yeremybautista77/Maquina_Expendedora/Firmware/imagenes_productos/p2.jpg

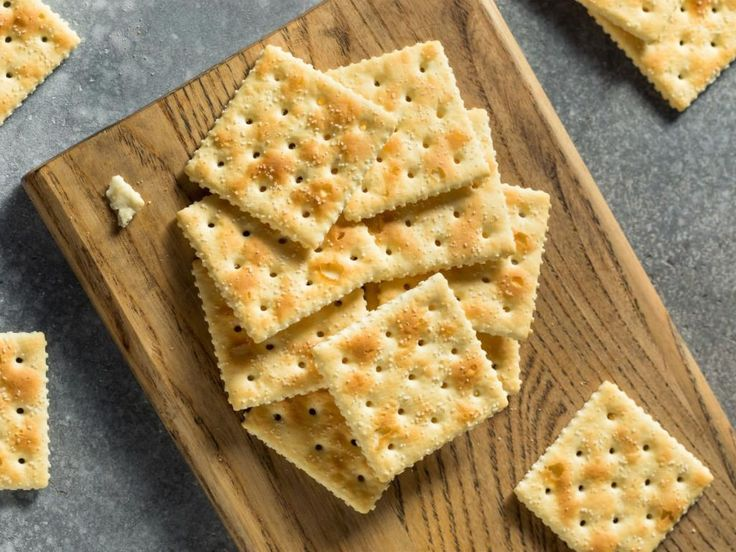
Firmware/imagenes_productos/p2.jpg
