yeremybautista77/Maquina_Expendedora/Firmware/imagenes_productos/p1.jpg

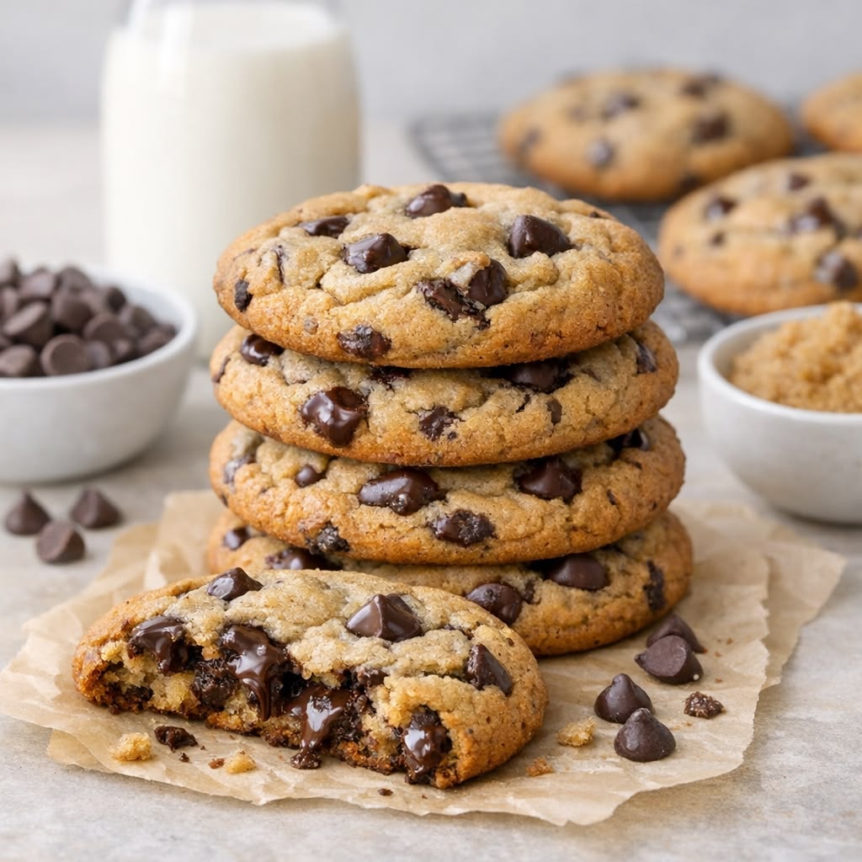
Firmware/imagenes_productos/p1.jpg
