yeremybautista77/Maquina_Expendedora/Diseño_electronico/img/README.md

Carpeta para fotografías y diagramas del documento ARQUITECTURA_HARDWARE.md.

Nombres esperados (ver índice de figuras, sección 5.1):

- placa_hosyond_esp32_32e.png
- cableado_general.png
- fuente_12v.png
- stepdown_lm2596.png
- optoacoplador_pc817.png
- monedero_ch926.png
- modulo_reles.png
- bus_i2c.png
- pantalla_st7796.png
- borneras_conexion.png
