yeremybautista77/Maquina_Expendedora/Diseño_mecanico/motor dc/motor main.SLDPRT

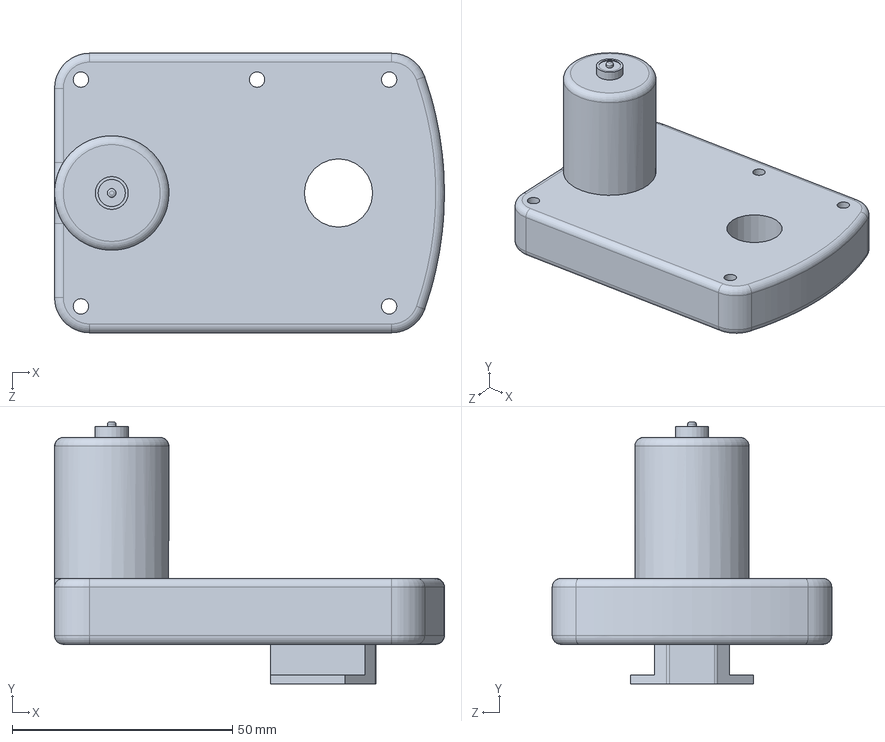
[picture p3: CAD file, 2026-11-04]
Diseño_mecanico/motor dc/motor main.SLDPRT
88.6 x 59.5 x 63.5 mm
