yeremybautista77/Maquina_Expendedora/Diseño_mecanico/motor dc/Ensamblaje de motor.SLDASM

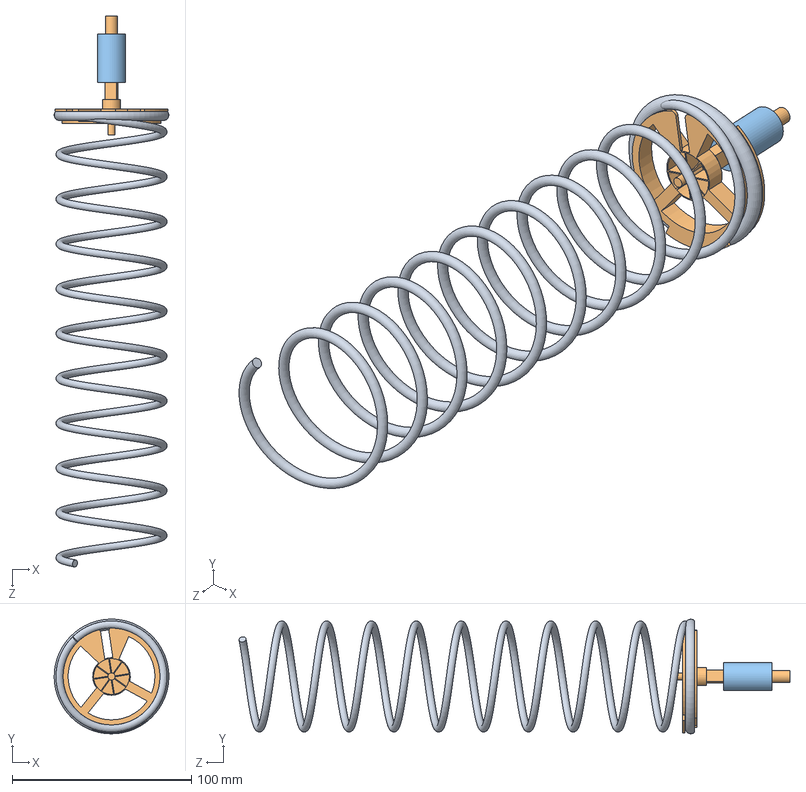
[picture p4: CAD file, 2026-11-04]
Diseño_mecanico/motor dc/Ensamblaje de motor.SLDASM
64.0 x 64.0 x 307.3 mm
eje de base del motor
base de resorte
espiral
