yeremybautista77/Maquina_Expendedora/Diseño_mecanico/Chasis/Ensamblaje1.SLDASM

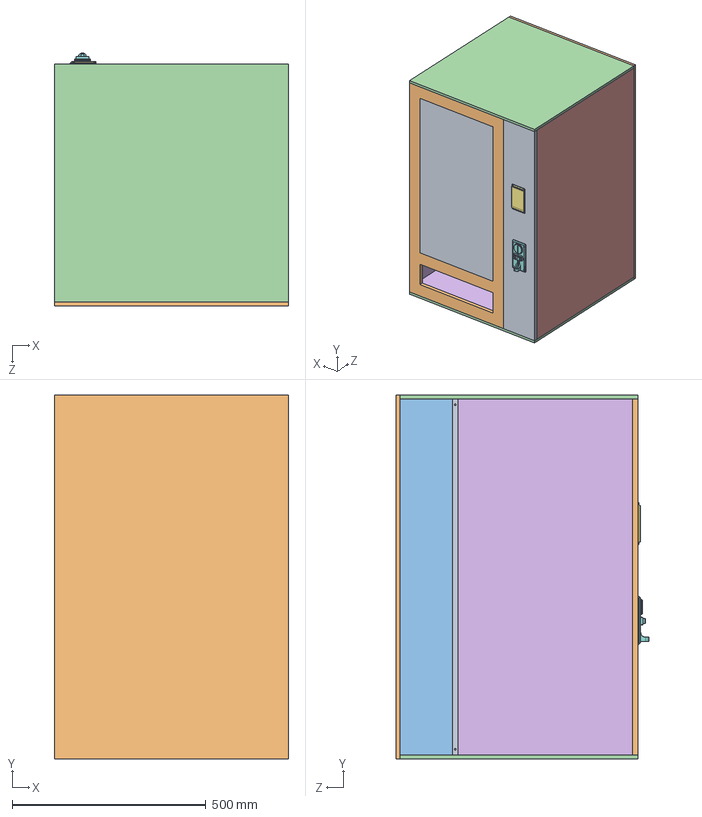
[picture p5: CAD file, 2026-11-04]
Diseño_mecanico/Chasis/Ensamblaje1.SLDASM
604.7 x 940.0 x 652.5 mm
Base de los motores
motor 2
motor main x 5
DIVISOR INTERIOR
eje de base del motor x 7
espiral x 7
base de resorte x 7
pared principal
PANEL DE CONTROL
coin acceptor
pantalla
fondo
pared exterior1
pared superior e inferior x 2
pared exterior 2
pared final
Cristal
