yeremybautista77/Maquina_Expendedora/Diseño_mecanico/Chasis/coin acceptor.SLDPRT

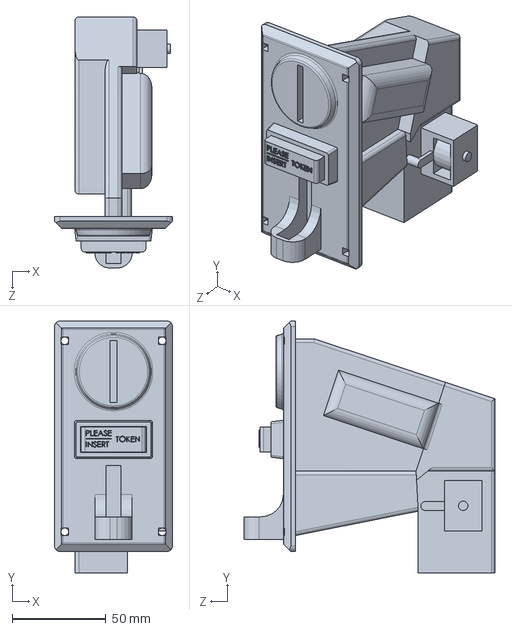
[picture p6: CAD file, 2026-11-04]
Diseño_mecanico/Chasis/coin acceptor.SLDPRT
63.0 x 134.5 x 134.0 mm
