yeremybautista77/Maquina_Expendedora/Diseño_mecanico/motor dc/espiral.SLDPRT

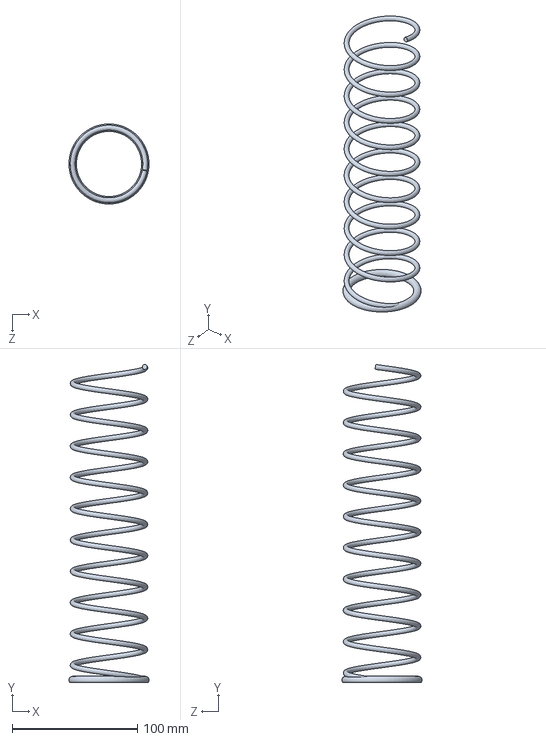
[picture p7: CAD file, 2026-11-04]
Diseño_mecanico/motor dc/espiral.SLDPRT
64.0 x 254.0 x 63.9 mm
