yeremybautista77/Maquina_Expendedora/Diseño_mecanico/Chasis/4 Inch TFT SPI 480x320 V1.2.SLDPRT

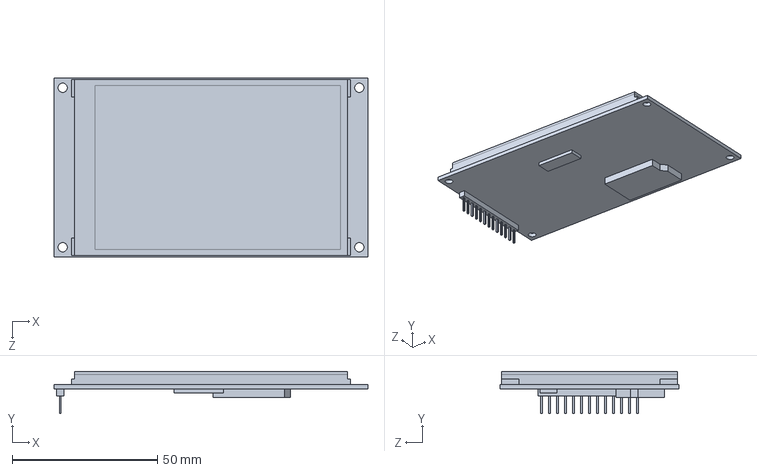
[picture p8: CAD file, 2026-11-04]
Diseño_mecanico/Chasis/4 Inch TFT SPI 480x320 V1.2.SLDPRT
108.0 x 14.5 x 61.7 mm
