yeremybautista77/Maquina_Expendedora/Diseño_mecanico/motor dc/motor 2.SLDPRT

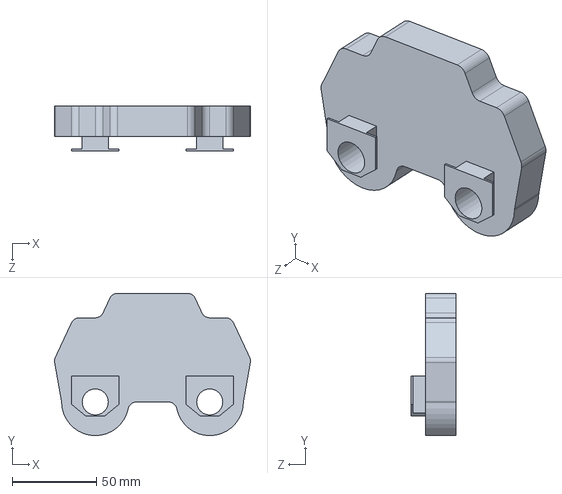
[picture p9: CAD file, 2026-11-04]
Diseño_mecanico/motor dc/motor 2.SLDPRT
116.4 x 84.5 x 26.5 mm
