yeremybautista77/Maquina_Expendedora/Diseño_mecanico/Chasis/fondo.SLDPRT

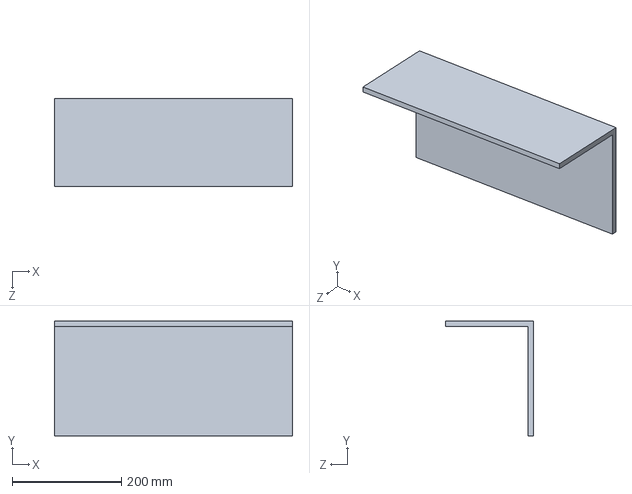
[picture p10: CAD file, 2026-11-04]
Diseño_mecanico/Chasis/fondo.SLDPRT
434.7 x 210.0 x 160.0 mm
