yeremybautista77/Maquina_Expendedora/Diseño_mecanico/Chasis/pared exterior1.SLDPRT

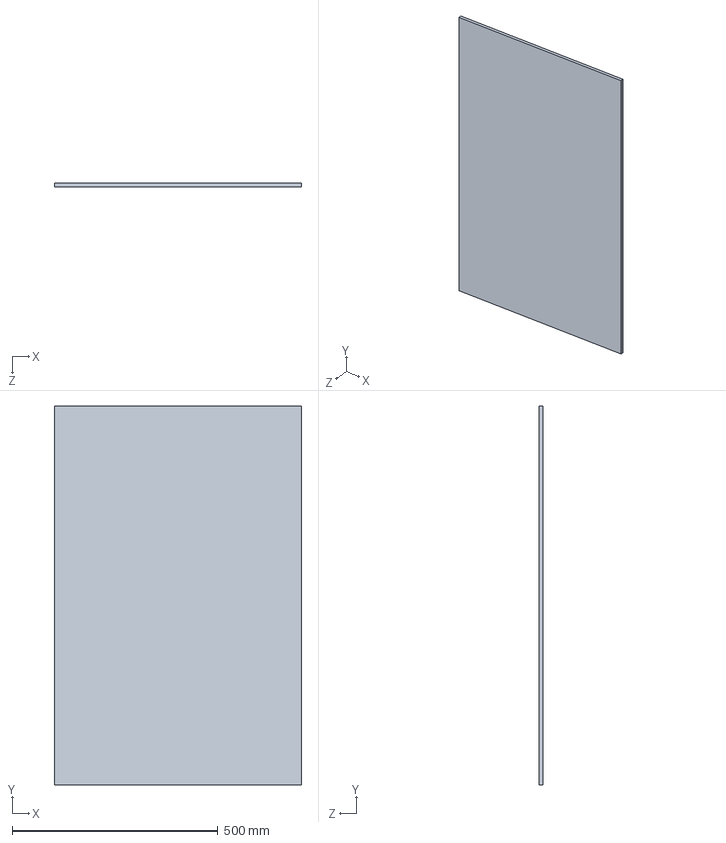
[picture p11: CAD file, 2026-11-04]
Diseño_mecanico/Chasis/pared exterior1.SLDPRT
600.0 x 920.0 x 10.0 mm
