yeremybautista77/Maquina_Expendedora/Diseño_mecanico/motor dc/eje de base del motor.SLDPRT

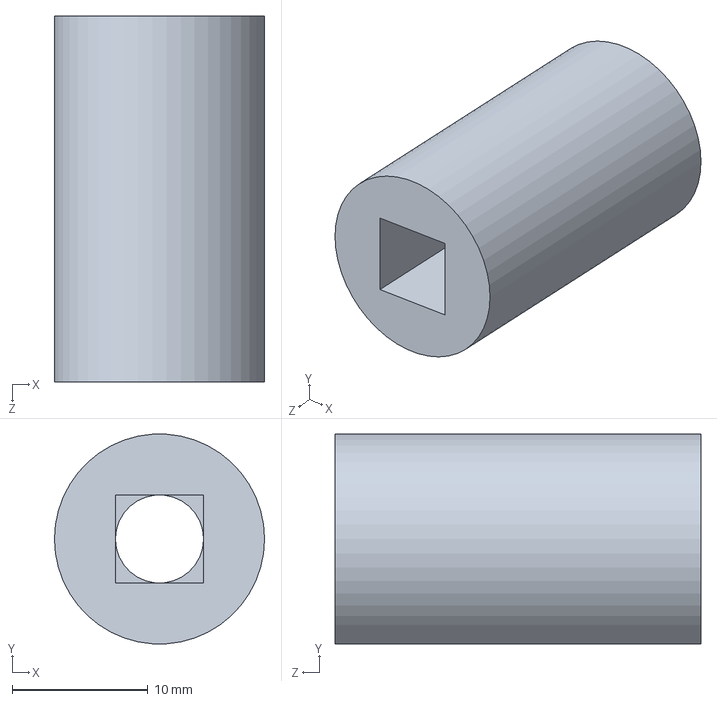
[picture p12: CAD file, 2026-11-04]
Diseño_mecanico/motor dc/eje de base del motor.SLDPRT
15.5 x 15.5 x 27.0 mm
