yeremybautista77/Maquina_Expendedora/Diseño_mecanico/Chasis/PANEL DE CONTROL.SLDPRT

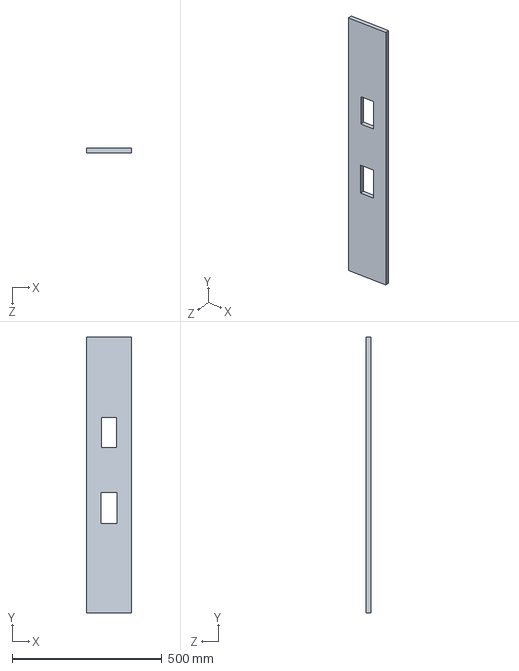
[picture p14: CAD file, 2026-11-04]
Diseño_mecanico/Chasis/PANEL DE CONTROL.SLDPRT
150.0 x 920.0 x 15.0 mm
