yeremybautista77/Maquina_Expendedora/Diseño_mecanico/motor dc/base de resorte.SLDPRT

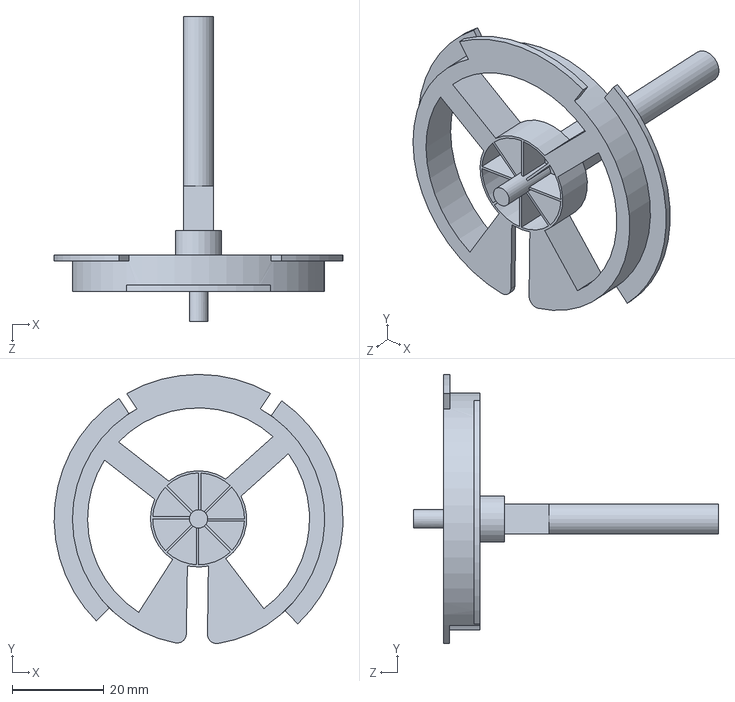
[picture p15: CAD file, 2026-11-04]
Diseño_mecanico/motor dc/base de resorte.SLDPRT
62.9 x 58.7 x 66.5 mm
