yeremybautista77/Maquina_Expendedora/Diseño_mecanico/Chasis/Cristal.SLDPRT

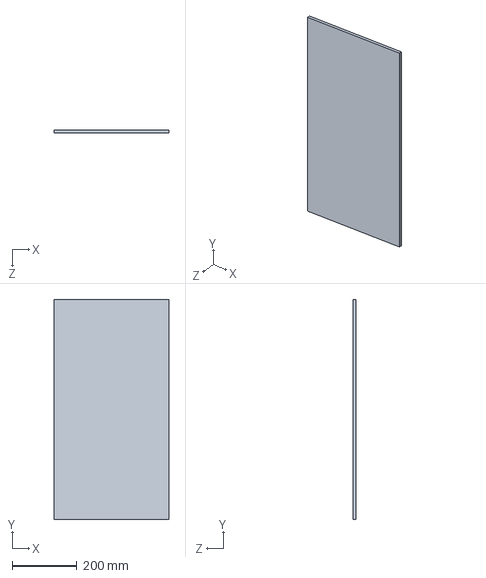
[picture p16: CAD file, 2026-11-04]
Diseño_mecanico/Chasis/Cristal.SLDPRT
354.7 x 680.0 x 10.0 mm
