yeremybautista77/Maquina_Expendedora/Diseño_mecanico/Chasis/pared exterior 2.SLDPRT

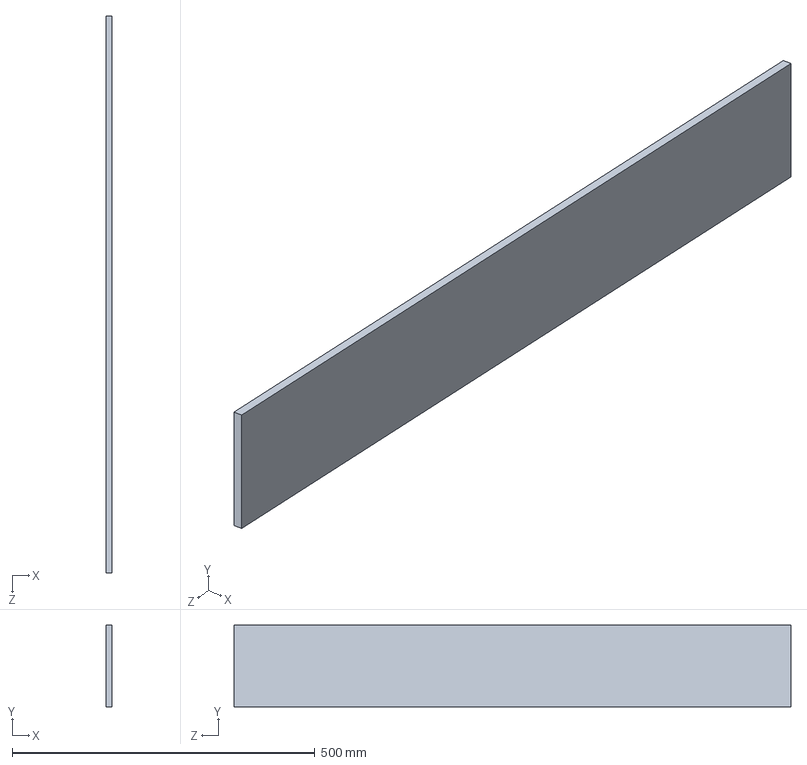
[picture p17: CAD file, 2026-11-04]
Diseño_mecanico/Chasis/pared exterior 2.SLDPRT
10.0 x 135.0 x 920.0 mm
