yeremybautista77/Maquina_Expendedora/Diseño_mecanico/Chasis/Base de los motores.SLDPRT

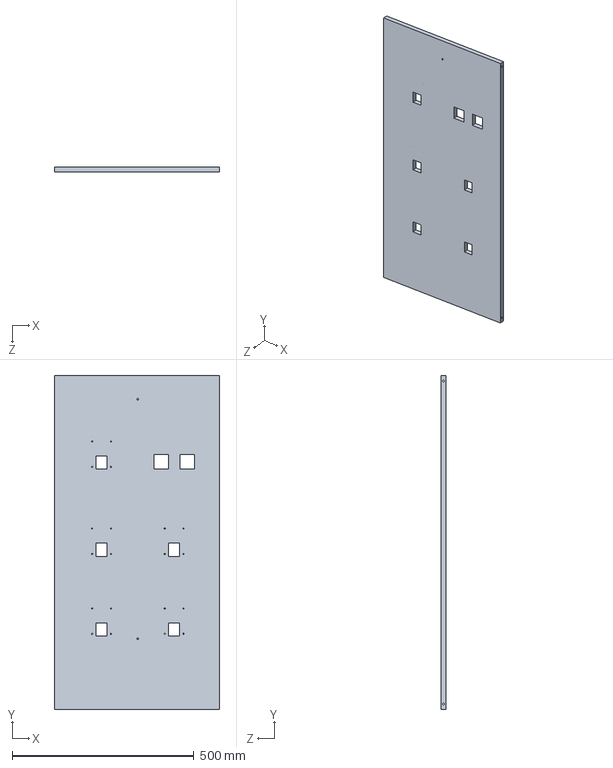
[picture p18: CAD file, 2026-11-04]
Diseño_mecanico/Chasis/Base de los motores.SLDPRT
454.7 x 920.0 x 15.0 mm
