yeremybautista77/Maquina_Expendedora/Diseño_mecanico/Chasis/pared final.SLDPRT

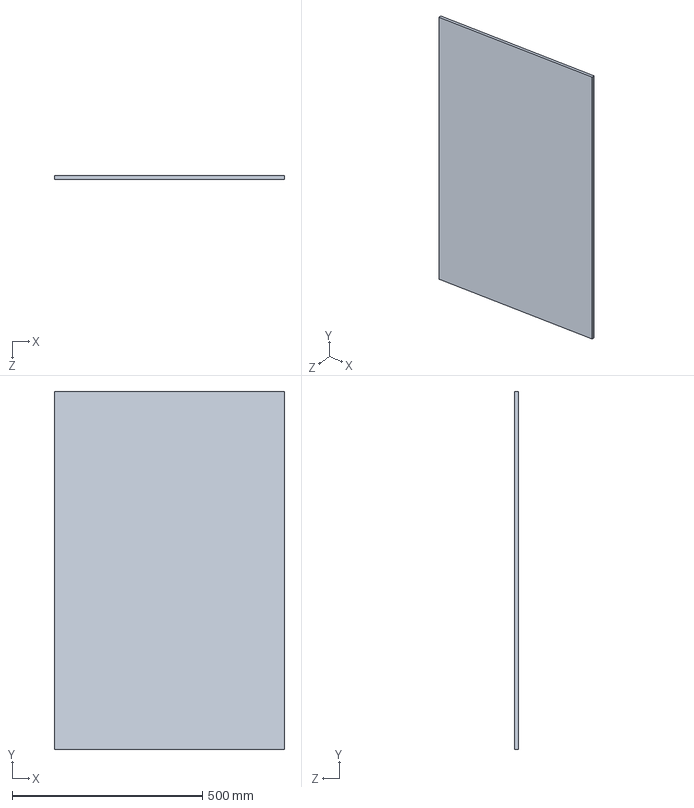
[picture p19: CAD file, 2026-11-04]
Diseño_mecanico/Chasis/pared final.SLDPRT
604.7 x 940.0 x 10.0 mm
