yeremybautista77/Maquina_Expendedora/Diseño_mecanico/Chasis/ultimas paredes.SLDPRT

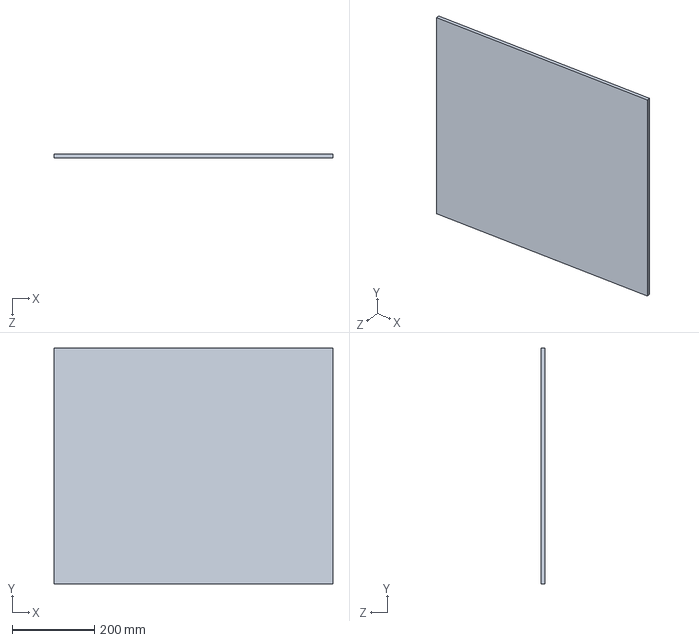
[picture p20: CAD file, 2026-11-04]
Diseño_mecanico/Chasis/ultimas paredes.SLDPRT
680.0 x 575.0 x 10.0 mm
