yeremybautista77/Maquina_Expendedora/Diseño_mecanico/Chasis/pared superior e inferior.SLDPRT

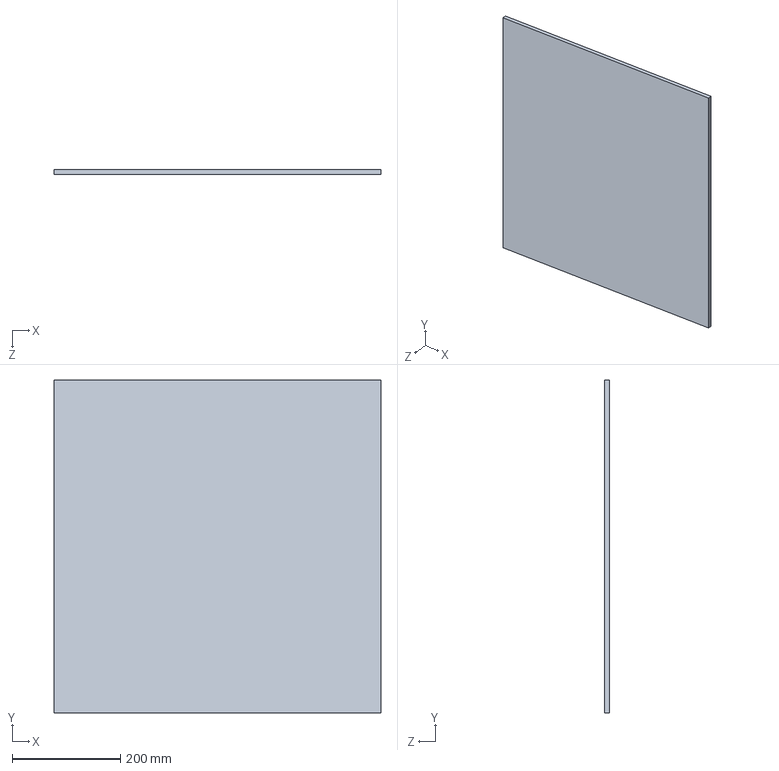
[picture p21: CAD file, 2026-11-04]
Diseño_mecanico/Chasis/pared superior e inferior.SLDPRT
604.7 x 615.0 x 10.0 mm
