yeremybautista77/Maquina_Expendedora/Diseño_mecanico/Chasis/DIVISOR INTERIOR.SLDPRT

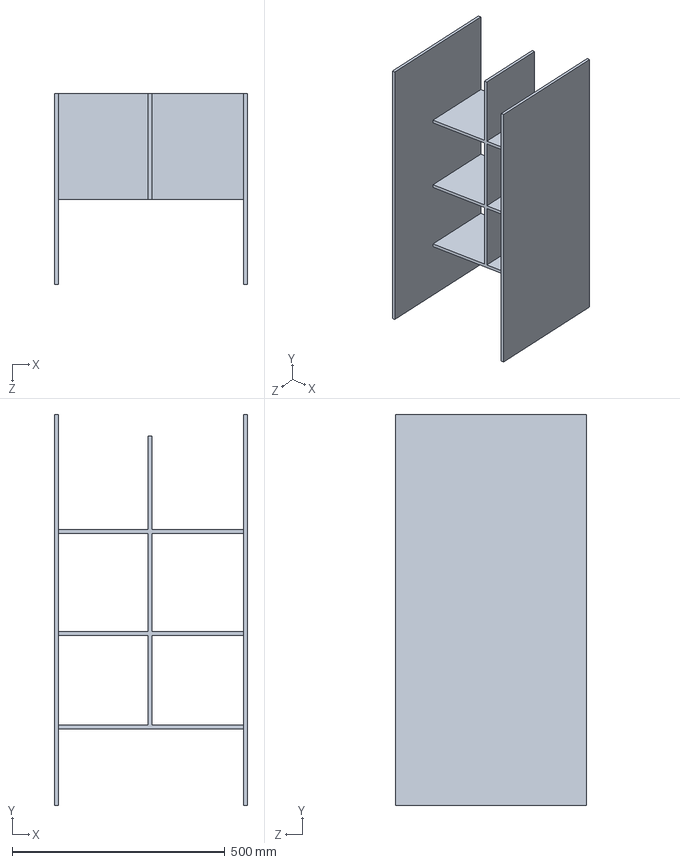
[picture p22: CAD file, 2026-11-04]
Diseño_mecanico/Chasis/DIVISOR INTERIOR.SLDPRT
454.7 x 920.0 x 450.0 mm
