yeremybautista77/Maquina_Expendedora/Diseño_mecanico/Chasis/PARED INTERIOR.SLDPRT

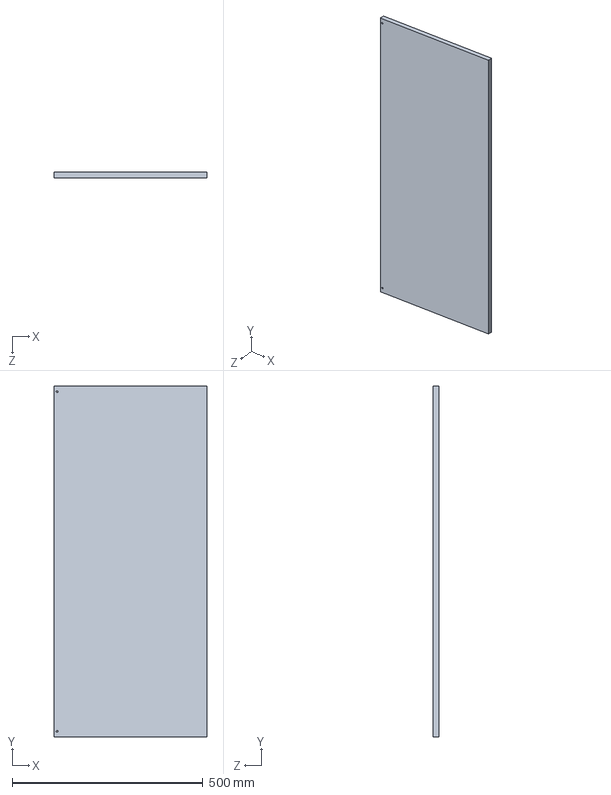
[picture p23: CAD file, 2026-11-04]
Diseño_mecanico/Chasis/PARED INTERIOR.SLDPRT
400.0 x 920.0 x 15.0 mm
