yeremybautista77/Maquina_Expendedora/(list of files, cad)

Other CAD files:
Diseño_mecanico/coin acceptor.SLDPRT
Diseño_mecanico/Chasis/pantalla.SLDPRT
