yeremybautista77/Maquina_Expendedora/Firmware/main/motor_control.c

/**
 * @file motor_control.c
 * @brief Control I2C de los 6 motores mediante el PCF8574 0x20 y lectura de
 *        los sensores de posicion M1..M4 por el PCF8574 0x21.
 *
 * Estrategia:
 *   - M1..M4 (con sensor): se energiza el rele y se espera el pulso de home
 *     para detener el motor en la misma posicion en cada vuelta. El pulso por
 *     tiempo actua como techo de seguridad si el sensor no responde.
 *   - M5..M6 (sin sensor): lazo abierto con MOTOR_TIMED_PULSE_MS.
 *   - Si el expansor 0x21 no responde, los 6 canales usan lazo abierto.
 *
 * SPDX-License-Identifier: MIT
 */

#include "motor_control.h"

#include <inttypes.h>
#include <stddef.h>

#include "board_config.h"
#include "esp_log.h"
#include "freertos/task.h"
#include "sensor_input.h"

static const char *TAG = "motor_control";

_Static_assert(MOTOR_CHANNEL_COUNT == BOARD_CHANNEL_COUNT,
               "El numero de canales de motor debe coincidir con el hardware");
_Static_assert(BOARD_SENSOR_CHANNEL_COUNT <= MOTOR_CHANNEL_COUNT,
               "Los canales con sensor deben ser un subconjunto de los motores");

/** Handle I2C del PCF8574 de relees (0x20). */
static i2c_master_dev_handle_t s_relay_dev = NULL;

/* La lectura del PCF8574 0x21 vive en sensor_input.c. */

/** Registro sombra: bit n = 1 significa que el canal n esta activo. */
static uint8_t s_relay_shadow = 0;

/** Mutex que serializa el acceso al bus I2C. */
static SemaphoreHandle_t s_i2c_mutex = NULL;

/** Cola de solicitudes de despacho. */
static QueueHandle_t s_dispatch_queue = NULL;

/** Mutex que protege la cola (productor GUI / consumidor motor_task). */
static SemaphoreHandle_t s_queue_mutex = NULL;

/** true mientras motor_control_dispatch_one() tiene el Mutex de despacho. */
static volatile bool s_dispatching = false;

/** true mientras motor_task esta procesando una solicitud o vaciando la cola. */
static volatile bool s_task_active = false;

/** Callback de eventos de despacho (registrado por main.c). */
static motor_event_cb_t s_event_cb = NULL;
static void *s_event_ctx = NULL;

/* --- Utilidades internas -------------------------------------------------- */

/**
 * @brief Emite un evento al callback registrado (contexto de motor_task).
 */
static void emit_event(motor_event_type_t type, uint8_t channel, uint8_t units,
                       esp_err_t error, bool admin_test)
{
    const motor_event_cb_t callback = s_event_cb;
    if (callback == NULL) {
        return;
    }

    const motor_event_t event = {
        .type = type,
        .channel = channel,
        .units = units,
        .error = error,
        .admin_test = admin_test,
    };
    callback(&event, s_event_ctx);
}

/**
 * @brief Agrega el PCF8574 al bus I2C.
 */
static esp_err_t add_expander(i2c_master_bus_handle_t bus, uint8_t address,
                              i2c_master_dev_handle_t *out_dev)
{
    const i2c_device_config_t dev_cfg = {
        .dev_addr_length = I2C_ADDR_BIT_LEN_7,
        .device_address = address,
        .scl_speed_hz = BOARD_I2C_CLOCK_HZ,
    };

    return i2c_master_bus_add_device(bus, &dev_cfg, out_dev);
}

/**
 * @brief Escribe un byte en un PCF8574 bajo el Mutex del bus.
 */
static esp_err_t write_expander(i2c_master_dev_handle_t dev, uint8_t value)
{
    if (dev == NULL || s_i2c_mutex == NULL) {
        return ESP_ERR_INVALID_STATE;
    }
    if (xSemaphoreTake(s_i2c_mutex, pdMS_TO_TICKS(100)) != pdTRUE) {
        return ESP_ERR_TIMEOUT;
    }

    esp_err_t err = i2c_master_transmit(dev, &value, sizeof(value), 100);

    xSemaphoreGive(s_i2c_mutex);
    return err;
}

/* --- API publica ---------------------------------------------------------- */

esp_err_t motor_control_init(i2c_master_bus_handle_t i2c_bus)
{
    if (i2c_bus == NULL) {
        return ESP_ERR_INVALID_ARG;
    }
    if (s_relay_dev != NULL && s_dispatch_queue != NULL &&
        s_queue_mutex != NULL) {
        return ESP_OK; /* Ya inicializado. */
    }

    s_i2c_mutex = xSemaphoreCreateMutex();
    if (s_i2c_mutex == NULL) {
        return ESP_ERR_NO_MEM;
    }

    /*
     * Diagnostico de presencia: add_device no verifica que el PCF8574 exista.
     * El probe deja en el log si 0x20 responde antes de escribir.
     */
    if (i2c_master_probe(i2c_bus, BOARD_I2C_ADDR_RELAY, 50) == ESP_OK) {
        ESP_LOGI(TAG, "PCF8574 de relees detectado en 0x%02X",
                 BOARD_I2C_ADDR_RELAY);
    } else {
        ESP_LOGE(TAG,
                 "PCF8574 de relees NO responde en 0x%02X (revise SDA/SCL, "
                 "3.3 V y GND comun)",
                 BOARD_I2C_ADDR_RELAY);
    }

    esp_err_t err = add_expander(i2c_bus, BOARD_I2C_ADDR_RELAY, &s_relay_dev);
    if (err != ESP_OK) {
        ESP_LOGE(TAG, "No se pudo registrar el PCF8574 de relees (0x%02X): %s",
                 BOARD_I2C_ADDR_RELAY, esp_err_to_name(err));
        goto fail;
    }

    /*
     * Estado seguro al arrancar: todos los canales apagados.
     * Con el inversor NPN (BOARD_RELAY_ACTIVE_LOW = 0) apagar es escribir LOW
     * en todos los bits (0x00): los transistores quedan al corte y la entrada
     * IN de cada modulo queda en alto (rele desenergizado).
     */
    s_relay_shadow = 0x00;
#if BOARD_RELAY_ACTIVE_LOW
    const uint8_t relay_off = 0xFF;
#else
    const uint8_t relay_off = 0x00;
#endif
    err = write_expander(s_relay_dev, relay_off);
    if (err != ESP_OK) {
        ESP_LOGE(TAG, "No se pudo apagar los relees al inicio: %s",
                 esp_err_to_name(err));
        goto fail;
    }

    s_queue_mutex = xSemaphoreCreateMutex();
    if (s_queue_mutex == NULL) {
        ESP_LOGE(TAG, "Sin memoria para el Mutex de la cola de despacho");
        err = ESP_ERR_NO_MEM;
        goto fail;
    }

    s_dispatch_queue = xQueueCreate(MOTOR_QUEUE_LENGTH, sizeof(motor_request_t));
    if (s_dispatch_queue == NULL) {
        ESP_LOGE(TAG, "Sin memoria para la cola de despacho");
        err = ESP_ERR_NO_MEM;
        goto fail;
    }

    /*
     * PCF8574 de sensores (0x21). Es opcional: si no responde, la maquina
     * sigue funcionando en lazo abierto por tiempo. La gestion del expansor y
     * la interpretacion del home viven en sensor_input.c.
     */
#if BOARD_SENSOR_ENABLED
    esp_err_t sensor_err = sensor_input_init(i2c_bus);
    if (sensor_err != ESP_OK) {
        ESP_LOGW(TAG,
                 "Sensores no disponibles (%s); M1-M%u pasaran a lazo abierto",
                 esp_err_to_name(sensor_err),
                 (unsigned)BOARD_SENSOR_CHANNEL_COUNT);
    }
#endif /* BOARD_SENSOR_ENABLED */

    if (sensor_input_available()) {
        ESP_LOGI(TAG,
                 "Control de motores listo (relees 0x%02X; sensores 0x%02X en "
                 "M1-M%u; M%u-M%u por tiempo %d ms)",
                 BOARD_I2C_ADDR_RELAY, BOARD_I2C_ADDR_SENSOR,
                 (unsigned)BOARD_SENSOR_CHANNEL_COUNT,
                 (unsigned)(BOARD_SENSOR_CHANNEL_COUNT + 1),
                 (unsigned)MOTOR_CHANNEL_COUNT, MOTOR_TIMED_PULSE_MS);
    } else {
        ESP_LOGI(TAG,
                 "Control de motores listo (relees 0x%02X; M1-M%u por tiempo, "
                 "%d ms)",
                 BOARD_I2C_ADDR_RELAY, (unsigned)MOTOR_CHANNEL_COUNT,
                 MOTOR_TIMED_PULSE_MS);
    }

#if BOARD_SENSOR_ENABLED && BOARD_SENSOR_HOMING_ENABLED
    /*
     * Homing opcional de arranque. Se ejecuta antes de crear motor_task, por
     * lo que no compite con ningun despacho. Un fallo no impide arrancar.
     */
    if (sensor_input_available()) {
        (void)motor_control_home_all();
    }
#endif

    return ESP_OK;

fail:
    if (s_dispatch_queue != NULL) {
        vQueueDelete(s_dispatch_queue);
        s_dispatch_queue = NULL;
    }
    if (s_queue_mutex != NULL) {
        vSemaphoreDelete(s_queue_mutex);
        s_queue_mutex = NULL;
    }
    if (s_relay_dev != NULL) {
        i2c_master_bus_rm_device(s_relay_dev);
        s_relay_dev = NULL;
    }
    if (s_i2c_mutex != NULL) {
        vSemaphoreDelete(s_i2c_mutex);
        s_i2c_mutex = NULL;
    }
    return err;
}

esp_err_t motor_control_set_relay(uint8_t channel, bool enabled)
{
    if (channel >= MOTOR_CHANNEL_COUNT) {
        return ESP_ERR_INVALID_ARG;
    }
    if (s_relay_dev == NULL || s_i2c_mutex == NULL) {
        return ESP_ERR_INVALID_STATE;
    }
    if (xSemaphoreTake(s_i2c_mutex, pdMS_TO_TICKS(100)) != pdTRUE) {
        return ESP_ERR_TIMEOUT;
    }

    const uint8_t mask = (uint8_t)(1u << channel);
    const uint8_t new_shadow = enabled ? (uint8_t)(s_relay_shadow | mask)
                                       : (uint8_t)(s_relay_shadow & (uint8_t)~mask);

#if BOARD_RELAY_ACTIVE_LOW
    const uint8_t physical = (uint8_t)~new_shadow;
#else
    const uint8_t physical = new_shadow;
#endif

    esp_err_t err = ESP_FAIL;
    for (int intento = 0; intento < 3; intento++) {
        err = i2c_master_transmit(s_relay_dev, &physical, sizeof(physical), 100);
        if (err == ESP_OK) {
            break;
        }
        vTaskDelay(pdMS_TO_TICKS(10));
    }

    if (err == ESP_OK) {
        s_relay_shadow = new_shadow;
        ESP_LOGI(TAG, "Canal %u -> %s (0x20 = 0x%02X)",
                 (unsigned)(channel + 1), enabled ? "ON" : "OFF",
                 (unsigned)physical);
    } else {
        ESP_LOGW(TAG, "Canal %u: fallo I2C al %s (%s)", (unsigned)(channel + 1),
                 enabled ? "encender" : "apagar", esp_err_to_name(err));
    }

    xSemaphoreGive(s_i2c_mutex);
    return err;
}

bool motor_control_sensors_available(void)
{
    return sensor_input_available();
}

bool motor_control_channel_uses_sensor(uint8_t channel)
{
    return sensor_input_is_channel(channel);
}

esp_err_t motor_control_read_sensors(uint8_t *out_mask)
{
    if (out_mask == NULL) {
        return ESP_ERR_INVALID_ARG;
    }
    if (!sensor_input_available()) {
        return ESP_ERR_NOT_SUPPORTED;
    }
    return sensor_input_read_mask(out_mask);
}

esp_err_t motor_control_read_sensor(uint8_t channel, bool *out_home)
{
    if (channel >= MOTOR_CHANNEL_COUNT || out_home == NULL) {
        return ESP_ERR_INVALID_ARG;
    }
    if (!motor_control_channel_uses_sensor(channel)) {
        /* M5/M6 no tienen micro-switch: se despachan por tiempo. */
        return ESP_ERR_NOT_SUPPORTED;
    }

    esp_err_t err = sensor_input_read_channel(channel, out_home);
    if (err == ESP_ERR_INVALID_STATE) {
        /* El expansor no esta disponible: se informa como no soportado. */
        return ESP_ERR_NOT_SUPPORTED;
    }
    return err;
}

esp_err_t motor_control_home_all(void)
{
    if (!sensor_input_available()) {
        return ESP_ERR_NOT_SUPPORTED;
    }
    if (g_dispatch_mutex == NULL) {
        return ESP_ERR_INVALID_STATE;
    }

    esp_err_t result = ESP_OK;
    ESP_LOGI(TAG, "Homing de M1-M%u (timeout %d ms por canal)",
             (unsigned)BOARD_SENSOR_CHANNEL_COUNT,
             BOARD_SENSOR_HOMING_TIMEOUT_MS);

    for (uint8_t channel = 0; channel < BOARD_SENSOR_CHANNEL_COUNT; channel++) {
        bool at_home = false;
        esp_err_t err = motor_control_read_sensor(channel, &at_home);
        if (err != ESP_OK) {
            ESP_LOGE(TAG, "Homing canal %u: fallo leyendo el sensor: %s",
                     (unsigned)(channel + 1), esp_err_to_name(err));
            if (result == ESP_OK) {
                result = err;
            }
            continue;
        }
        if (at_home) {
            ESP_LOGI(TAG, "Homing canal %u: ya esta en reposo",
                     (unsigned)(channel + 1));
            continue;
        }

        if (xSemaphoreTake(g_dispatch_mutex,
                           pdMS_TO_TICKS(BOARD_SENSOR_HOMING_TIMEOUT_MS +
                                         2000)) != pdTRUE) {
            ESP_LOGE(TAG, "Homing canal %u: Mutex de despacho ocupado",
                     (unsigned)(channel + 1));
            if (result == ESP_OK) {
                result = ESP_ERR_TIMEOUT;
            }
            continue;
        }

        /* Se relee bajo el Mutex: el canal pudo moverse mientras se esperaba. */
        err = motor_control_read_sensor(channel, &at_home);
        if (err != ESP_OK) {
            ESP_LOGE(TAG, "Homing canal %u: fallo releyendo el sensor: %s",
                     (unsigned)(channel + 1), esp_err_to_name(err));
        } else if (!at_home) {
            ESP_LOGW(TAG, "Homing canal %u: fuera de reposo, energizando rele",
                     (unsigned)(channel + 1));

            err = motor_control_set_relay(channel, true);
            if (err != ESP_OK) {
                ESP_LOGE(TAG, "Homing canal %u: no se pudo activar el rele: %s",
                         (unsigned)(channel + 1), esp_err_to_name(err));
            } else {
                const TickType_t start = xTaskGetTickCount();
                const TickType_t timeout =
                    pdMS_TO_TICKS(BOARD_SENSOR_HOMING_TIMEOUT_MS);

                for (;;) {
                    bool home_now = false;
                    err = motor_control_read_sensor(channel, &home_now);
                    if (err != ESP_OK || home_now) {
                        break;
                    }
                    if ((xTaskGetTickCount() - start) >= timeout) {
                        err = ESP_ERR_TIMEOUT;
                        break;
                    }
                    vTaskDelay(pdMS_TO_TICKS(BOARD_SENSOR_POLL_MS));
                }

                /* El rele se apaga SIEMPRE, tambien si vencio el timeout. */
                const esp_err_t off_err =
                    motor_control_set_relay(channel, false);
                if (off_err != ESP_OK) {
                    ESP_LOGE(TAG, "Homing canal %u: FALLO APAGANDO EL RELE: %s",
                             (unsigned)(channel + 1), esp_err_to_name(off_err));
                    if (err == ESP_OK) {
                        err = off_err;
                    }
                }

                if (err == ESP_OK) {
                    ESP_LOGI(TAG, "Homing canal %u: reposo alcanzado",
                             (unsigned)(channel + 1));
                } else {
                    ESP_LOGE(TAG, "Homing canal %u: no se alcanzo el reposo: %s",
                             (unsigned)(channel + 1), esp_err_to_name(err));
                }
            }
            vTaskDelay(pdMS_TO_TICKS(MOTOR_SETTLE_MS));
        }

        xSemaphoreGive(g_dispatch_mutex);

        if (err != ESP_OK && result == ESP_OK) {
            result = err;
        }
    }

    if (result == ESP_OK) {
        ESP_LOGI(TAG, "Homing completado: M1-M%u en reposo",
                 (unsigned)BOARD_SENSOR_CHANNEL_COUNT);
    } else {
        ESP_LOGW(TAG, "Homing incompleto (%s); se continua el arranque",
                 esp_err_to_name(result));
    }
    return result;
}

esp_err_t motor_control_check_capacity(uint8_t count)
{
    if (count == 0 || count > MOTOR_QUEUE_LENGTH) {
        return ESP_ERR_INVALID_ARG;
    }
    if (s_dispatch_queue == NULL || s_queue_mutex == NULL) {
        return ESP_ERR_INVALID_STATE;
    }

    if (xSemaphoreTake(s_queue_mutex, pdMS_TO_TICKS(100)) != pdTRUE) {
        ESP_LOGW(TAG, "Mutex de la cola ocupado; no se pudo validar capacidad");
        return ESP_ERR_TIMEOUT;
    }

    const UBaseType_t spaces = uxQueueSpacesAvailable(s_dispatch_queue);
    xSemaphoreGive(s_queue_mutex);

    if (spaces < (UBaseType_t)count) {
        ESP_LOGW(TAG,
                 "Capacidad insuficiente: %u solicitud(es), %u hueco(s) libre(s)",
                 (unsigned)count, (unsigned)spaces);
        return ESP_ERR_TIMEOUT;
    }
    return ESP_OK;
}

esp_err_t motor_control_enqueue_batch(const motor_request_t *requests,
                                      uint8_t count)
{
    if (requests == NULL || count == 0 || count > MOTOR_QUEUE_LENGTH) {
        return ESP_ERR_INVALID_ARG;
    }
    for (uint8_t i = 0; i < count; i++) {
        if (requests[i].channel >= MOTOR_CHANNEL_COUNT ||
            requests[i].quantity == 0) {
            return ESP_ERR_INVALID_ARG;
        }
    }
    if (s_dispatch_queue == NULL || s_queue_mutex == NULL) {
        return ESP_ERR_INVALID_STATE;
    }

    /*
     * Todo el lote se valida y se encola bajo el mismo Mutex. Como solo la GUI
     * produce solicitudes y motor_task solo consume, no hay otro productor que
     * pueda ocupar los huecos entre la comprobacion y los xQueueSend.
     */
    if (xSemaphoreTake(s_queue_mutex, pdMS_TO_TICKS(100)) != pdTRUE) {
        ESP_LOGW(TAG, "Mutex de la cola ocupado; lote no encolado");
        return ESP_ERR_TIMEOUT;
    }

    const UBaseType_t spaces = uxQueueSpacesAvailable(s_dispatch_queue);
    if (spaces < (UBaseType_t)count) {
        xSemaphoreGive(s_queue_mutex);
        ESP_LOGW(TAG,
                 "Pedido rechazado: %u solicitud(es), solo %u hueco(s) libre(s)",
                 (unsigned)count, (unsigned)spaces);
        return ESP_ERR_TIMEOUT;
    }

    for (uint8_t i = 0; i < count; i++) {
        if (xQueueSend(s_dispatch_queue, &requests[i], 0) != pdTRUE) {
            /*
             * No puede ocurrir con un unico productor y capacidad validada;
             * si ocurriera, el pedido quedaria parcial y se informa como error.
             */
            xSemaphoreGive(s_queue_mutex);
            ESP_LOGE(TAG,
                     "Fallo inesperado al encolar el canal %u (lote parcial)",
                     (unsigned)(requests[i].channel + 1));
            return ESP_ERR_TIMEOUT;
        }
    }

    xSemaphoreGive(s_queue_mutex);

    for (uint8_t i = 0; i < count; i++) {
        ESP_LOGI(TAG, "Solicitud encolada: canal %u x %u unidad(es)",
                 (unsigned)(requests[i].channel + 1),
                 (unsigned)requests[i].quantity);
    }
    return ESP_OK;
}

esp_err_t motor_control_enqueue(uint8_t channel, uint8_t quantity)
{
    const motor_request_t request = {
        .channel = channel,
        .quantity = quantity,
    };
    return motor_control_enqueue_batch(&request, 1);
}

esp_err_t motor_control_set_event_callback(motor_event_cb_t callback, void *ctx)
{
    /*
     * Se publica primero el contexto y despues el puntero a la funcion. El
     * callback solo se invoca desde motor_task, que se crea despues de esta
     * llamada en app_main().
     */
    s_event_ctx = ctx;
    s_event_cb = callback;
    return ESP_OK;
}

esp_err_t motor_control_cancel_pending(uint32_t *out_discarded)
{
    if (s_dispatch_queue == NULL || s_queue_mutex == NULL) {
        return ESP_ERR_INVALID_STATE;
    }

    if (xSemaphoreTake(s_queue_mutex, pdMS_TO_TICKS(100)) != pdTRUE) {
        return ESP_ERR_TIMEOUT;
    }

    uint32_t discarded = 0;
    motor_request_t request;
    while (xQueueReceive(s_dispatch_queue, &request, 0) == pdTRUE) {
        discarded++;
    }

    xSemaphoreGive(s_queue_mutex);

    if (out_discarded != NULL) {
        *out_discarded = discarded;
    }
    if (discarded > 0) {
        ESP_LOGW(TAG, "Canceladas %" PRIu32 " solicitud(es) pendiente(s)",
                 discarded);
    }
    return ESP_OK;
}

bool motor_control_is_busy(void)
{
    if (s_dispatch_queue == NULL) {
        return false;
    }

    UBaseType_t pending = 0;
    if (s_queue_mutex != NULL &&
        xSemaphoreTake(s_queue_mutex, 0) == pdTRUE) {
        pending = uxQueueMessagesWaiting(s_dispatch_queue);
        xSemaphoreGive(s_queue_mutex);
    } else {
        pending = uxQueueMessagesWaiting(s_dispatch_queue);
    }

    return s_task_active || s_dispatching || (pending > 0);
}

esp_err_t motor_control_dispatch_one(uint8_t channel, uint32_t mutex_timeout_ms)
{
    if (channel >= MOTOR_CHANNEL_COUNT) {
        return ESP_ERR_INVALID_ARG;
    }
    if (g_dispatch_mutex == NULL) {
        ESP_LOGE(TAG, "g_dispatch_mutex no fue creado por app_main()");
        return ESP_ERR_INVALID_STATE;
    }

    if (xSemaphoreTake(g_dispatch_mutex, pdMS_TO_TICKS(mutex_timeout_ms)) != pdTRUE) {
        ESP_LOGW(TAG, "Mutex de despacho ocupado; no se pudo iniciar el canal %u",
                 (unsigned)(channel + 1));
        return ESP_ERR_TIMEOUT;
    }

    s_dispatching = true;
    bool relay_on = false;
    esp_err_t result = ESP_OK;

    bool use_sensor =
        motor_control_channel_uses_sensor(channel) && sensor_input_available();
    bool at_home = false;

    /*
     * Lectura inicial tolerante: si el sensor falla antes de arrancar, se usa
     * el pulso por tiempo para no cancelar una compra por un glitch de I2C.
     */
    if (use_sensor) {
        result = motor_control_read_sensor(channel, &at_home);
        if (result != ESP_OK) {
            ESP_LOGW(TAG,
                     "Canal %u: fallo leyendo el sensor (%s); se usara pulso "
                     "por tiempo",
                     (unsigned)(channel + 1), esp_err_to_name(result));
            use_sensor = false;
            result = ESP_OK;
        }
    }

    if (use_sensor) {
        /*
         * Canal con sensor (M1..M4): el motor arranca y se detiene en el
         * pulso de home. El tiempo solo actua como techo de seguridad.
         */
        if (!at_home) {
            ESP_LOGW(TAG, "Canal %u: fuera de home; se completara la vuelta",
                     (unsigned)(channel + 1));
        }

        result = motor_control_set_relay(channel, true);
        if (result != ESP_OK) {
            ESP_LOGE(TAG, "Canal %u: no se pudo activar el rele: %s",
                     (unsigned)(channel + 1), esp_err_to_name(result));
            goto cleanup;
        }
        relay_on = true;

        bool left_home = !at_home;
        const TickType_t leave_start = xTaskGetTickCount();

        /* Si arranca en home, primero debe abandonarlo. */
        if (at_home) {
            const TickType_t leave_timeout =
                pdMS_TO_TICKS(BOARD_SENSOR_LEAVE_TIMEOUT_MS);
            for (;;) {
                bool home_now = false;
                result = motor_control_read_sensor(channel, &home_now);
                if (result != ESP_OK) {
                    break;
                }
                if (!home_now) {
                    left_home = true;
                    break;
                }
                if ((xTaskGetTickCount() - leave_start) >= leave_timeout) {
                    ESP_LOGE(TAG, "Canal %u: el motor no abandono el home en %d ms",
                             (unsigned)(channel + 1),
                             BOARD_SENSOR_LEAVE_TIMEOUT_MS);
                    result = ESP_ERR_TIMEOUT;
                    break;
                }
                vTaskDelay(pdMS_TO_TICKS(BOARD_SENSOR_POLL_MS));
            }
        }

        /* Esperar la vuelta completa: el sensor vuelve a home. */
        if (result == ESP_OK && left_home) {
            const TickType_t travel_start = xTaskGetTickCount();
            const TickType_t travel_timeout =
                pdMS_TO_TICKS(BOARD_SENSOR_TRAVEL_TIMEOUT_MS);

            ESP_LOGI(TAG, "Canal %u: motor en marcha, esperando home",
                     (unsigned)(channel + 1));

            for (;;) {
                bool home_now = false;
                result = motor_control_read_sensor(channel, &home_now);
                if (result != ESP_OK) {
                    break;
                }

                const uint32_t elapsed_ms =
                    (uint32_t)(xTaskGetTickCount() - travel_start) *
                    portTICK_PERIOD_MS;

                if (home_now && elapsed_ms >= BOARD_SENSOR_MIN_PULSE_MS) {
                    ESP_LOGI(TAG, "Canal %u: home alcanzado en %lu ms",
                             (unsigned)(channel + 1),
                             (unsigned long)elapsed_ms);
                    break;
                }
                if ((xTaskGetTickCount() - travel_start) >= travel_timeout) {
                    ESP_LOGE(TAG,
                             "Canal %u: timeout esperando home (%d ms)",
                             (unsigned)(channel + 1),
                             BOARD_SENSOR_TRAVEL_TIMEOUT_MS);
                    result = ESP_ERR_TIMEOUT;
                    break;
                }
                vTaskDelay(pdMS_TO_TICKS(BOARD_SENSOR_POLL_MS));
            }
        }
    } else {
        /* Canal sin sensor (M5/M6) o expansor 0x21 no disponible. */
        result = motor_control_set_relay(channel, true);
        if (result != ESP_OK) {
            ESP_LOGE(TAG, "Canal %u: no se pudo activar el rele: %s",
                     (unsigned)(channel + 1), esp_err_to_name(result));
            goto cleanup;
        }
        relay_on = true;

        ESP_LOGI(TAG, "Canal %u: pulso por tiempo de %d ms",
                 (unsigned)(channel + 1), MOTOR_TIMED_PULSE_MS);
        vTaskDelay(pdMS_TO_TICKS(MOTOR_TIMED_PULSE_MS));
        ESP_LOGI(TAG, "Canal %u: pulso completado", (unsigned)(channel + 1));
    }

cleanup:
    /* El rele se apaga SIEMPRE, incluso ante error. */
    if (relay_on) {
        esp_err_t off_err = motor_control_set_relay(channel, false);
        if (off_err != ESP_OK) {
            ESP_LOGE(TAG, "Canal %u: FALLO APAGANDO EL RELE: %s",
                     (unsigned)(channel + 1), esp_err_to_name(off_err));
            if (result == ESP_OK) {
                result = off_err;
            }
        }
    }

    s_dispatching = false;
    vTaskDelay(pdMS_TO_TICKS(MOTOR_SETTLE_MS));
    xSemaphoreGive(g_dispatch_mutex);
    return result;
}

void motor_task(void *arg)
{
    (void)arg;

    if (s_dispatch_queue == NULL) {
        ESP_LOGE(TAG, "motor_task sin cola inicializada; tarea finalizada");
        vTaskDelete(NULL);
        return;
    }

    ESP_LOGI(TAG, "Tarea de despacho iniciada");

    motor_request_t request;
    for (;;) {
        if (xQueueReceive(s_dispatch_queue, &request, portMAX_DELAY) != pdTRUE) {
            continue;
        }

        s_task_active = true;
        bool failed = false;

        ESP_LOGI(TAG, "Despachando canal %u x %u unidad(es)",
                 (unsigned)(request.channel + 1), (unsigned)request.quantity);

        for (uint8_t unit = 0; unit < request.quantity; unit++) {
            /*
             * Margen para esperar a que otro motor termine su unidad: el
             * recorrido por sensor (M1..M4) o el pulso por tiempo (M5..M6).
             */
            const uint32_t mutex_wait_ms =
                BOARD_SENSOR_LEAVE_TIMEOUT_MS +
                BOARD_SENSOR_TRAVEL_TIMEOUT_MS +
                MOTOR_SETTLE_MS + 1000;
            esp_err_t err = motor_control_dispatch_one(request.channel, mutex_wait_ms);
            if (err != ESP_OK) {
                ESP_LOGE(TAG, "Despacho abortado en canal %u (unidad %u): %s",
                         (unsigned)(request.channel + 1), (unsigned)(unit + 1),
                         esp_err_to_name(err));
                emit_event(MOTOR_EVENT_REQUEST_FAILED, request.channel,
                           (uint8_t)(request.quantity - unit), err,
                           request.admin_test);
                failed = true;
                break;
            }

            /*
             * La unidad salio fisicamente: se notifica de inmediato para que la
             * GUI descuente saldo/stock solo por unidades realmente entregadas.
             */
            emit_event(MOTOR_EVENT_UNIT_DONE, request.channel, 1, ESP_OK,
                       request.admin_test);

            if ((unit + 1) < request.quantity) {
                vTaskDelay(pdMS_TO_TICKS(MOTOR_REPEAT_DELAY_MS));
            }
        }

        if (failed) {
            /*
             * Politica del pedido: si un motor falla, se descarta el resto de la
             * cola. La GUI conserva el saldo de las unidades no entregadas y no
             * reduce su stock.
             */
            motor_request_t discarded_request;
            uint32_t discarded = 0;
            while (xQueueReceive(s_dispatch_queue, &discarded_request, 0) == pdTRUE) {
                discarded++;
            }
            if (discarded > 0) {
                ESP_LOGW(TAG, "Pedido cancelado: %" PRIu32 " solicitud(es) descartada(s)",
                         discarded);
            }
        }

        s_task_active = false;

        if (!failed && uxQueueMessagesWaiting(s_dispatch_queue) == 0) {
            emit_event(MOTOR_EVENT_IDLE, 0, 0, ESP_OK, request.admin_test);
        }
    }
}
