yeremybautista77/Maquina_Expendedora/Firmware/main/product_images.c

/**
 * @file product_images.c
 * @brief Imagenes de los 6 productos embebidas en flash.
 *
 * ARCHIVO GENERADO: no editar a mano. Ejecuta
 * herramientas/generar_imagenes.ps1 para regenerarlo.
 *
 * Formato: RGB565 con bytes intercambiados (LV_COLOR_16_SWAP = 1),
 * el mismo que produce el decodificador BMP de LVGL en esta placa.
 *
 * SPDX-License-Identifier: MIT
 */

#include "product_images.h"

#include "lvgl.h"

#ifndef LV_ATTRIBUTE_MEM_ALIGN
#define LV_ATTRIBUTE_MEM_ALIGN
#endif
#ifndef LV_ATTRIBUTE_LARGE_CONST
#define LV_ATTRIBUTE_LARGE_CONST
#endif

static const LV_ATTRIBUTE_MEM_ALIGN LV_ATTRIBUTE_LARGE_CONST uint8_t product_img_1_map[] = {
    0xd6,0x9a,0xde,0xdb,0xd6,0xba,0xd6,0xba,0xd6,0xba,0xd6,0xba,0xd6,0x9a,0xce,0x7a,
    0xef,0x7e,0xef,0x5d,0xef,0x7e,0xef,0x5d,0xe7,0x3c,0xe7,0x3c,0xe7,0x3c,0xe7,0x3c,
    0xef,0x5d,0xe7,0x5d,0xe7,0x3d,0xd6,0xbb,0xce,0x59,0xd6,0x9a,0xd6,0x9a,0xd6,0x9a,
    0xd6,0x9a,0xce,0x9a,0xce,0x7a,0xce,0x7a,0xce,0x7a,0xce,0x9a,0xce,0x7a,0xce,0x7a,
    0xce,0x7a,0xce,0x7a,0xce,0x59,0xc6,0x39,0xc6,0x39,0xc6,0x39,0xc6,0x39,0xc6,0x39,
    0xc6,0x39,0xc6,0x39,0xc6,0x39,0xc6,0x39,0xc6,0x19,0xc6,0x18,0xc6,0x18,0xc6,0x18,
    0xc6,0x19,0xc6,0x19,0xc6,0x59,0xc6,0x39,0xd6,0x9a,0xde,0xfc,0xde,0xdb,0xde,0xdb,
    0xde,0xdb,0xde,0xdb,0xde,0xbb,0xe7,0x1c,0xff,0xdf,0xff,0xde,0xff,0xff,0xff,0xde,
    0xf7,0x9d,0xf7,0x9d,0xf7,0x9d,0xf7,0x9d,0xf7,0xbe,0xf7,0xbe,0xff,0xdf,0xf7,0x9e,
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
    &product_img_1,
    &product_img_2,
    &product_img_3,
    &product_img_4,
    &product_img_5,
    &product_img_6,
};

const lv_img_dsc_t *product_images_get(uint8_t index)
{
    if (index >= PRODUCT_IMAGE_COUNT) {
        return NULL;
    }
    return s_images[index];
}
