yeremybautista77/Maquina_Expendedora/Firmware/main/coin_acceptor.h

/**
 * @file coin_acceptor.h
 * @brief Lectura del monedero multimoneda por interrupcion de hardware (IO35)
 *        y decodificacion de rafagas de pulsos en Pesos Dominicanos.
 *
 * Arquitectura (Secciones 2 y 3):
 *
 *   Moneda        Pulsos        Valor
 *   RD$ 1            1          RD$  1.00
 *   RD$ 5            3          RD$  5.00
 *   RD$ 10           5          RD$ 10.00
 *   RD$ 25           7          RD$ 25.00
 *
 *   La ISR solo cuenta pulsos y los deposita en una cola. La tarea del monedero
 *   abre una ventana de 300 ms: cada pulso nuevo reinicia el temporizador; si
 *   pasan 300 ms sin actividad se cierra la rafaga, se valida la cantidad de
 *   pulsos y se informa el valor mediante el callback registrado.
 *
 *   Robustez contra saldo fantasma:
 *   - Se ignoran los pulsos de los primeros COIN_STARTUP_IGNORE_MS tras el
 *     arranque (transitorios de encendido).
 *   - Solo cuenta un pulso cuyo ancho este entre COIN_PULSE_MIN_WIDTH_MS y
 *     COIN_PULSE_MAX_WIDTH_MS; asi se descartan glitches de EMI y una linea
 *     flotante (monedero sin conectar).
 *   - Al cerrar la rafaga la linea debe estar en reposo (HIGH); si sigue en
 *     LOW la rafaga se descarta.
 *   - El monedero solo se arma cuando la linea lleva COIN_ARM_STABLE_MS en
 *     reposo estable; si se queda en nivel activo se desarma.
 *
 * SPDX-License-Identifier: MIT
 */

#pragma once

#include <stdint.h>

#include "esp_err.h"

#ifdef __cplusplus
extern "C" {
#endif

/** Cantidad de pulsos por denominacion (Seccion 3). */
#define COIN_PULSES_RD1             1
#define COIN_PULSES_RD5             3
#define COIN_PULSES_RD10            5
#define COIN_PULSES_RD25            7

/** Silencio (ms) que determina el final de una rafaga. */
#define COIN_BURST_GAP_MS           300

/** Antirrebote por pulso (ms). */
#define COIN_PULSE_DEBOUNCE_MS      20

/**
 * Tiempo (ms) tras coin_acceptor_init() durante el cual se descartan todos los
 * pulsos. Al conectar/desconectar la alimentacion (USB o fuente) la linea del
 * optoacoplador se comporta como una antena y genera flancos falsos; esa ventana
 * evita que se acredite saldo fantasma en cada arranque.
 */
#define COIN_STARTUP_IGNORE_MS      2500

/**
 * Ancho valido de un pulso del monedero (ms).
 *
 * El optoacoplador PC817 entrega un pulso de decenas de milisegundos. Un glitch
 * de EMI dura microsegundos y una linea flotante (monedero sin conectar) se
 * queda en LOW demasiado tiempo: ambos casos se descartan. Ajustar solo si el
 * monedero real entrega anchos distintos.
 */
#define COIN_PULSE_MIN_WIDTH_MS     10
#define COIN_PULSE_MAX_WIDTH_MS     150

/**
 * Reposo estable (ms) que debe mostrar la linea antes de que el firmware
 * empiece a aceptar monedas. Con el monedero desconectado, IO35 queda flotante:
 * exigir este reposo evita que el ruido se acredite como saldo.
 */
#define COIN_ARM_STABLE_MS          500

/**
 * Tiempo (ms) que la linea puede permanecer en el nivel activo antes de
 * considerar que el monedero se desconecto o quedo pegado en LOW. Se usa un
 * margen amplio (1 s) para no desarmar el monedero si una moneda tarda en
 * pasar por el mecanismo.
 */
#define COIN_DISARM_AFTER_MS        1000

/**
 * @brief Callback invocado al cerrar una rafaga de pulsos.
 *
 * Se ejecuta en el contexto de coin_acceptor_task(), nunca en la ISR.
 *
 * @param pulses Cantidad de pulsos detectados en la rafaga.
 * @param cents  Valor reconocido en centavos (0 si la rafaga no es valida).
 * @param ctx    Contexto opcional registrado por el llamador.
 */
typedef void (*coin_acceptor_cb_t)(uint8_t pulses, uint32_t cents, void *ctx);

/**
 * @brief Configura GPIO35 como entrada con interrupcion por ambos flancos,
 *        instala el servicio de ISR y crea la cola de pulsos.
 *
 * GPIO35 no tiene pull-up interno: la placa debe aportar uno externo.
 *
 * @return ESP_OK en exito, ESP_ERR_NO_MEM si no hay cola, o error de GPIO.
 */
esp_err_t coin_acceptor_init(void);

/**
 * @brief Registra el callback que recibira cada rafaga valida.
 *
 * @param cb  Funcion a invocar (NULL para desregistrar).
 * @param ctx Contexto de usuario.
 */
void coin_acceptor_set_callback(coin_acceptor_cb_t cb, void *ctx);

/**
 * @brief Traduce una rafaga de pulsos a centavos.
 *
 * @param pulses Pulsos detectados.
 * @return 100, 500, 1000 o 2500 centavos; 0 si la rafaga no corresponde a una
 *         moneda valida.
 */
uint32_t coin_acceptor_pulses_to_cents(uint8_t pulses);

/**
 * @brief Tarea FreeRTOS del monedero.
 *
 * Debe crearse con xTaskCreate() despues de coin_acceptor_init().
 * Prioridad sugerida: 10 (la mas alta del sistema, para no perder pulsos).
 */
void coin_acceptor_task(void *arg);

#ifdef __cplusplus
}
#endif
