yeremybautista77/Maquina_Expendedora/(commit log)

2026-10-22 Proyecto Final Maquina Expendedora - Documento de Diseno y Arquitectura
2026-10-24 Update technical documentation: Arquitectura y Plan de Proyecto (6 Canales)
2026-10-24 Rewrite main README: project description, materials, connections and authors
2026-10-24 Update technical documentation: ESP-IDF, monedero, I2C, GUI, mutex and scalability
2026-10-25 Firmware P0: GUI ST7796/XPT2046 con LVGL y cobro diferido por unidad
    - gui_display: panel ST7796 320x480 por SPI2, tactil XPT2046 en sondeo, LEDC, grid 2x3 con BMP de la MicroSD, modal de confirmacion y toast. Estado protegido por Mutex; LVGL solo se usa desde task_gui.
    - Compra: confirmar solo encola el pedido. El saldo y el stock se descuentan en gui_display_on_unit_dispatched() cuando el motor confirma la vuelta (sensor LOW). Ante fallo se descarta la cola y no se cobra lo no entregado.
    - motor_control: eventos UNIT_DONE/REQUEST_FAILED/IDLE, callback registrable y cancel_pending(). main.c los adapta a la GUI.
    - Dependencias gestionadas (LVGL 8.4.0, esp_lcd_st7796, esp_lcd_touch_xpt2046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
2026-10-25 fix(gui): rutas LVGL con barra inicial y buffer estatico para lv_img_set_src
    El driver FS stdio concatena LV_FS_STDIO_PATH sin separador, por lo que la ruta debe ser S:/productos/pN.bmp. Ademas lv_img_set_src no copia la cadena: se guarda en el struct de la celda para que el puntero siga vivo.
2026-10-25 docs: actualizar README y estado del proyecto para la fase P0
2026-10-25 docs(estado): resumen de hecho/falta, cambios de la sesion y checklist de puesta en marcha
2026-10-26 feat(firmware): pines confirmados, homing, NVS y rediseno de la GUI
    - board_config.h: pines confirmados fisicamente (I2C SDA=IO32/SCL=IO25, TFT/tactil y MicroSD); se eliminan las etiquetas TODO_VERIFICAR_PINES.
    - motor_control: motor_control_home_all() secuencial con g_dispatch_mutex y timeout de 10 s por canal; se ejecuta al final de motor_control_init().
    - NVS: nvs_flash_init() en main.c; saldo y stock de los 6 productos se cargan al arrancar y se guardan al acreditar monedas y en cada unidad cobrada (namespace vending).
    - GUI: grid estricto 2x3 (83% superior) con cabecera nombre+precio, recuadro [Espacio Imagen] y fila [-] Cant: N [+]; panel inferior de 80 px con Saldo, Monto a Pagar r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
2026-10-26 docs(estado): estado actual, tabla por bloque y dos preguntas pendientes
    Resume lo que esta hecho (pines, homing, NVS, GUI, cobro diferido), lo que falta (validacion en placa, encolado atomico, modo administracion, pruebas/CI, V2.0) y agrega la seccion 0 con las dos preguntas para el usuario: push a GitHub y flasheo/monitor.
2026-10-26 docs(estado): no fijar el numero de commits pendientes de push
2026-10-26 fix(gui): layout 2x3 real con Flex ROW_WRAP y celdas al 48 por ciento
    - El contenedor de productos usa LV_LAYOUT_FLEX + LV_FLEX_FLOW_ROW_WRAP en lugar de LV_GRID.
    - Cada celda mide LV_PCT(48) de ancho y 127 px de alto: solo caben dos por fila, forzando el salto de linea y el grid 2x3.
    - Se elimina lv_obj_set_grid_cell y los descriptores de columnas/filas.
    - ESTADO_DEL_PROYECTO.md: respuestas a las preguntas 1 y 2, layout actualizado y build 589 936 B (0x90070).
2026-10-26 docs(estado): registrar push exitoso y bloqueo del flasheo por falta de puerto COM
    - Push completado: fbe3060..80f3282.
    - Intento de flasheo con COM3: build OK, esptool no pudo abrir el puerto; no hay ningun COM presente.
    - Se actualiza el estado por bloque (push hecho, flasheo pendiente) y el checklist.
2026-10-26 feat(p1): encolado atomico y modo administracion oculto
    Encolado atomico (riesgo #4):
    - motor_control.c: s_queue_mutex serializa capacidad y encolado; motor_control_check_capacity() valida el pedido completo y motor_control_enqueue_batch() encola todo-o-nada.
    - motor_control_enqueue() queda como envoltorio de una solicitud; cancel_pending e is_busy usan el mutex de cola.
    - gui_display_confirm_purchase() valida capacidad antes de registrar el pedido; si no cabe, mantiene el modal y avisa 'Cola ocupada: reduzca la cantidad'. Si el lote falla, revierte el pedido completo.
    Modo administracion:
    - Boton invisible 40x40 en la esquina superior izquierda con LV_EVENT_LONG_PRESSED a 3 s (long_pre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
2026-10-26 docs(estado): registrar P1 completada y push 9639a48
    - Encolado atomico y modo administracion marcados como completados en tablas y checklist.
    - Build final 592 512 B (0x90a80), 43 % libre.
    - Flasheo pendiente por falta de puerto COM.
2026-10-26 feat(firmware): ampliar modo administracion con precios NVS y test de motores
2026-10-26 docs(firmware): actualizar comentario de carga NVS de precios
2026-10-26 docs: actualizacion de arquitectura y readme con fase P1
2026-10-26 docs(hardware): documentar arquitectura electrica, arbol de potencia y pinout
2026-10-26 docs(hardware): corregir power tree a bobinas de 12 V y simplificar tierras
2026-10-26 refactor: renombrar Codigo/ a Firmware/ en el repositorio
2026-10-26 docs(hardware): ajustar presupuesto de corriente del LM2596
2026-10-28 feat(motor): estrategia hibrida M1-M4 por sensor y M5-M6 por tiempo
    M1-M4 (LK20052 de 3 hilos) leen el micro-switch de 12 V a traves de un divisor externo 10 kOhm / 3.3 kOhm (~2.97 V) sobre P0-P3 del PCF8574 0x21, sin cortar pistas. La polaridad de reposo se abstrae con SENSOR_HOME_LEVEL (1 = HIGH).
    M5-M6 (LK20052 Fy-007 de 2 hilos) no tienen sensor: se despachan en lazo abierto con un pulso calibrado de 2.0 s sobre su rele de 0x20. P4/P5 de 0x21 quedan sin conexion y motor_control_read_sensor() devuelve ESP_ERR_NOT_SUPPORTED.
    El homing de arranque se limita a M1-M4 y el timeout del Mutex se ajusta por tipo de canal.
2026-10-28 docs(hardware): documentar estrategia hibrida de 6 motores y divisor 10k/3.3k
    Actualiza ARQUITECTURA_HARDWARE.md a la version 1.2 (28-oct-2026): diagrama Mermaid con M1-M4/M5-M6 y bloque de acondicionamiento, seccion 3.3 reescrita con calculo del divisor, matriz 4.6 hibrida, BOM, riesgos y glosario.
    Alinea README raiz, Firmware/README.md, ESTADO_DEL_PROYECTO.md y el documento tecnico: M1-M4 en bucle cerrado con SENSOR_HOME_LEVEL, M5-M6 en lazo abierto con pulso de ~2.0 s, P4/P5 de 0x21 sin conexion y placa LK20052 intacta (sin corte de pistas).
2026-10-28 chore(repo): reemplazar .gitkeep por README vacio y limpiar archivos generados
    Elimina los seis .gitkeep (contenian 'placeholder') y conserva las carpetas vacias con un README.md de 0 bytes en Diseno_mecanico, Documentacion Proyecto Terminado y Documentacion/Imagenes de manufactura.
    Elimina Firmware/sdkconfig (generado por ESP-IDF, ignorado por Git y regenerado desde sdkconfig.defaults) y la carpeta local .vscode. Se conserva Firmware/.gitignore porque evita versionar build/, sdkconfig, managed_components/ y dependencies.lock.
2026-10-30 fix(gui): calibrar pantalla y tactil, corregir colores y monto a pagar
    ST7796: activar BOARD_TFT_MIRROR_X (imagen reflejada) y desactivar BOARD_TFT_INVERT_COLOR, que invertia el tema y los colores (verde -> rosado, rojo -> cian).
    XPT2046: ajustar BOARD_TOUCH_MIRROR_X = 0 y BOARD_TOUCH_MIRROR_Y = 1 para compensar la rotacion de 180 grados. Validado en placa: cada boton +/- afecta su propio canal M1-M6.
    GUI: 'Monto a Pagar:' y el importe en dos lineas y en rojo; boton 'Confirmar' en verde, sin corchetes y siempre habilitado (la validacion se hace al pulsarlo).
    Docs: estado del proyecto y tamanos de build actualizados a 612 080 B (0x956f0).
2026-10-30 fix(monedero): evitar saldo fantasma con IO35 flotante
    Diagnostico: sin monedero conectado, IO35 (input-only, sin pull-up interno) queda flotante. Los transitorios al conectar/desconectar la pantalla generaban pulsos sueltos que se acreditaban como RD y quedaban guardados en NVS (se acumularon RD.00).\n\ncoin_acceptor:\n- ISR por ambos flancos: solo cuenta pulsos de 10-150 ms de ancho (descarta glitches de EMI y lineas pegadas en LOW).\n- Ventana de gracia de 2500 ms tras el arranque.\n- Armado solo cuando la linea lleva 500 ms en reposo (HIGH); se desarma si se queda en nivel activo.\n- La rafaga se descarta si la linea no volvio al reposo.\n- Log de diagnostico del nivel inicial de IO35 y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
2026-10-30 feat(monedero): diagnostico de flancos en IO35 para puesta en marcha
    Se agrega un contador de flancos de activacion en la ISR y un log cada 2 s cuando hay actividad: 'IO35: N flanco(s) nuevo(s), M rechazado(s)'. Permite distinguir cableado ausente, pulsos descartados por ancho y monedero sin armar.\n\nDocs: build actualizado a 613 664 B (0x95d20), 41 % libre.
2026-10-30 fix(monedero): ampliar a 1 s el umbral de desarme por linea en LOW
    En la prueba real con el CH-926 (NO + FAST) se vieron dos desarmes por 'la linea no volvio al reposo': el umbral de 250 ms era demasiado corto cuando una moneda tarda en pasar por el mecanismo. Ahora la linea debe permanecer 1 s en el nivel activo para desarmar.\n\nValidado en placa: 1 pulso = RD, 3 = RD, 5 = RD, 7 = RD; saldo acumulado RD.00 y persistido en NVS tras reinicio.
2026-10-30 fix(gui): distinguir motores no disponibles de cola llena
    Sin los PCF8574 conectados, motor_control_init() falla y la cola de despacho no existe; motor_control_check_capacity() devuelve ESP_ERR_INVALID_STATE y la GUI mostraba 'Cola ocupada: reduzca la cantidad', que confundia.\n\nAhora, si el control de motores no esta inicializado, la GUI avisa 'Motores no disponibles: conecte los modulos I2C' tanto al confirmar una compra como en la prueba de motores del modo administracion. El mensaje de cola llena se conserva para ESP_ERR_TIMEOUT.\n\nDocs: build 613 872 B (0x95df0), 41 % libre.
2026-10-30 feat(admin): acceso por boton ADM con contrasena y ajuste de saldo
    Se elimina el atajo por pulsacion larga y el boton invisible de la esquina superior izquierda. El panel inferior incorpora un boton ADM (46x40 px) junto a Confirmar que abre un teclado numerico; la contrasena provisional es 0000 y se valida al teclear el cuarto digito (C borra, OK reintenta). Solo con la clave correcta se construye el panel del operador.\\n\\nEl panel admin ahora incluye una seccion Saldo con botones -1/-5/-10/-25 y +1/+5/+10/+25, persistida en NVS al instante y acotada a RD$ 0.00-10 000.00. Se conserva Inventario y Precios. Se elimina la seccion de prueba de motores y su callback on_admin_test_clicked; el so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
2026-11-01 docs(estado): registrar montaje con expansor PCF8574 y solo M5/M6
    Se anota en el handoff que el expansor de pines ya esta conectado y que por ahora solo se montaran M5 y M6 (sin sensor). Queda pendiente capturar el arranque para confirmar 'Control de motores listo' y probar el pulso por tiempo de M5/M6.
2026-11-04 diseño mecanico en cad subido
2026-11-04 motores y documentacion actualizados
2026-11-05 feat(motores): reles con NPN inversor y los 6 canales validados en placa
    - 6 modulos de rele de 1 canal (SRD-12VDC-SL-C) con jumper H/L en LOW
    - Transistor NPN inversor por canal: P0..P5 -> 1 kOhm -> BASE,
    EMISOR -> GND, COLECTOR -> IN del modulo
    - BOARD_RELAY_ACTIVE_LOW = 0: el PCF8574 enciende con HIGH y apaga con LOW
    - Estado seguro 0x00 al arrancar y log del byte fisico escrito en 0x20
    - Monedero deshabilitado (BOARD_COIN_ACCEPTOR_ENABLED = 0); saldo por ADM
    - BRINGUP_TEST_MOTOR1 = 0 (modo produccion)
    - M1..M6 probados: rele, giro de 3 s, parada y cobro correcto
    - Documentacion (README, firmware, arquitectura tecnica y de hardware,
    estado del proyecto) actualizada al montaje real
    - .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
2026-11-06 docs(plan): precisar sensores M1-M4 en 0x21 y M5-M6 por tiempo
2026-11-06 feat(v1.0): sensores M1-M4, monedero e imagenes en flash
    - sensor_input: PCF8574 0x21 para M1-M4 (home=LOW, fallback a tiempo)
    - motor_control: lazo cerrado M1-M4, M5-M6 por tiempo, homing opcional
    - monedero CH-926 habilitado por IO35 (BOARD_COIN_ACCEPTOR_ENABLED=1)
    - imagenes de producto embebidas en flash (product_images.c/.h + generador)
    - MicroSD desactivada (BOARD_SD_ENABLED=0)
    - precios P1-P3 RD y P4-P6 RD/80/90 (provisional), migracion prices_v=3
    - UI: panel inferior 82 px, saldo/total en una linea, ADM 40x40, Confirmar 110x60
    - contrasena de administracion 20250456 (8 digitos)
    - cantidades del carrito a cero al cerrar el pedido
    - documentacion actualizada (README, ESTADO, arquitectu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
2026-11-06 docs: reflejar prueba de banco con un motor en M1-M6 y flasheo final
    Se actualiza el estado real: sensores y reles probados con un solo motor recorriendo los 6 canales; falta el montaje definitivo de los 6 motores y la prueba del monedero con monedas reales.
